MohamedMoustafa-embed/Alwah-project/مشروع الواح/Three-Band-Resistor-Color-Code.jpg

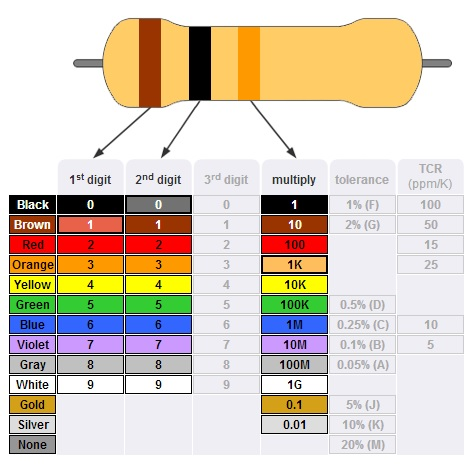
مشروع الواح/Three-Band-Resistor-Color-Code.jpg
