MohamedMoustafa-embed/Alwah-project/مشروع الواح/FRIIQKTJFIIWAOO.png

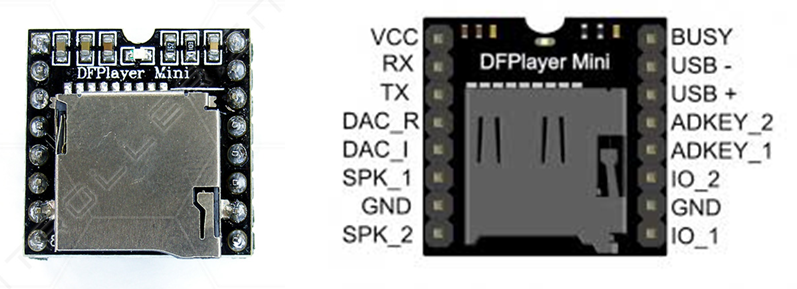
مشروع الواح/FRIIQKTJFIIWAOO.png
