MohamedMoustafa-embed/Alwah-project/مشروع الواح/PCB/Buttons_tray/push buttons.png

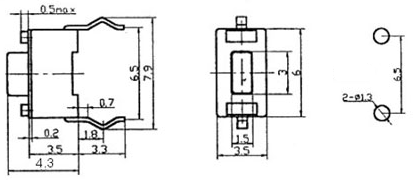
مشروع الواح/PCB/Buttons_tray/push buttons.png
