MohamedMoustafa-embed/Alwah-project/مشروع الواح/PCB/smd-resistor.png

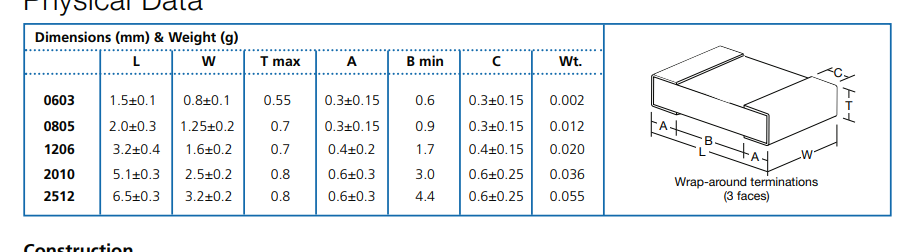
مشروع الواح/PCB/smd-resistor.png
