MohamedMoustafa-embed/Alwah-project/مشروع الواح/PCB/V2-1layer/tp4056.png

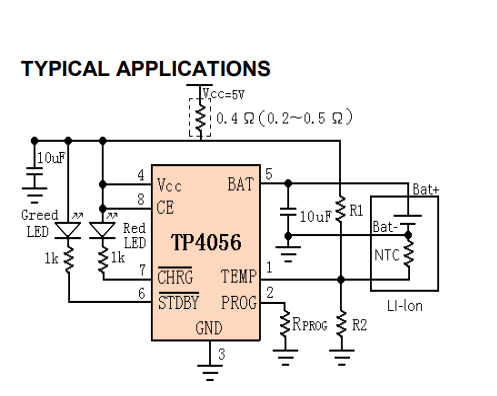
مشروع الواح/PCB/V2-1layer/tp4056.png
