MohamedMoustafa-embed/Alwah-project/مشروع الواح/untitled.png

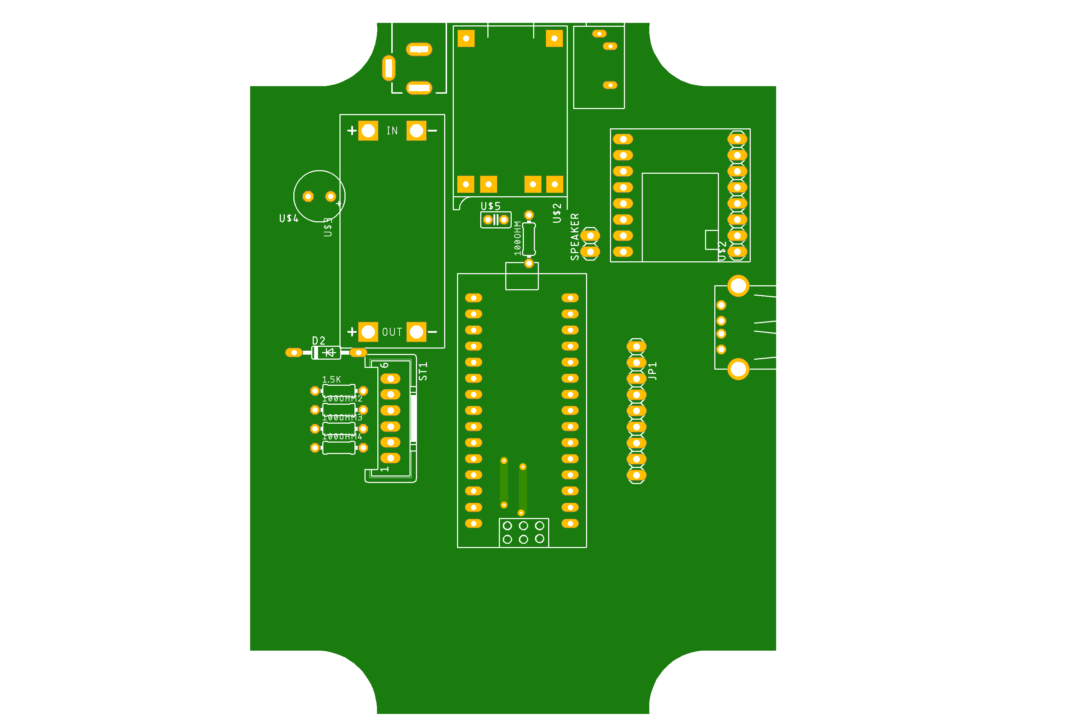
مشروع الواح/untitled.png
