MohamedMoustafa-embed/Alwah-project/Untitled spreadsheet.xlsx

Battery | 20 | tot | 10989.25249 |  | pricing list for Alwah Project |  |  |  |  | Estimating
battery holder | 10 |  |  |  | part1 | PCB |  |  |  | Board Alwah for one device | 20
battery charge module | 20 |  |  |  |  | Quantity | price |  |  | push-buttons for one board
Switches *20 | 10 |  |  |  |  | 75 | 3000 | 2200 | shipping and pproduct
Long switches *22 | 11 |  |  |  |  |  |  | 800 | customs
Arduino | 90
Mp3 | 100 |  |  |  | part2 | Components | From makers elecctronics
wires | 10 |  |  |  |  | Battery | 45
case | 50 |  |  |  |  | Charching module | 18
pcb fabrication | 30 |  |  |  |  | Step-up converter | 20
Sd card |  |  |  |  |  | At-mega8 | 30 | 28 at Ram electronic iin cairo
atmega | 35 |  |  |  |  | MP3 -Module | 60
push buttons *6 | 15 |  |  |  |  | Speaker | 8
additional as res, cap | 10 |  |  |  |  | socket | 8
step up module | 20 |  |  |  |  | LEDs | 1
printing | 15 |  |  |  |  | sd card | 26
 |  |  |  |  |  | additional compo | 20 | connectors,resistors,capacitor,switch,regulator 5v
 |  |  |  |  |  | caase | 40
 |  |  |  |  |  | push buttons
 |  |  |  |  |  |  | 276
 |  |  |  |  | part3 | Board Alwah
 |  |  |  |  |  | Push-buttons | 10
 |  |  |  |  |  | Wood | 7
 |  |  |  |  |  | cutting | 3
 |  |  |  |  |  | printing | 7
 |  |  |  |  |  | wax | 1
ADC calculator
 |  |  |  |  |  |  | 28
R1 | 152.8 | ohm |  | R1 | 10000 | ohm
R2(out) | 10 | ohm |  | R2(out) | 10 | ohm
vin | 5 | v |  | vin | 5 | v
voltage | 0.3071253071 | volt |  | voltage | 0.004995004995 | volt
ADC-readings-8bit(1023) | 62.8992629 |  |  | ADC-readings-8bit(1023) | 1.022977023
 |  | Difrrence | 61.87628588
ADC | 60 |  | 1~5 | "+1k"
R1 | 20 |  | 6~7 | "+1.2k"
R2(out) | 1.246105919 |  | 8~10 | "+2.2k"
ADC | 1
R2(out) | 10
R1 | 10220 |  | new R | 10067.2
