MohamedMoustafa-embed/Alwah-project/مشروع الواح/PCB/Buttons_tray/choosing-ayah-buttons.dxf

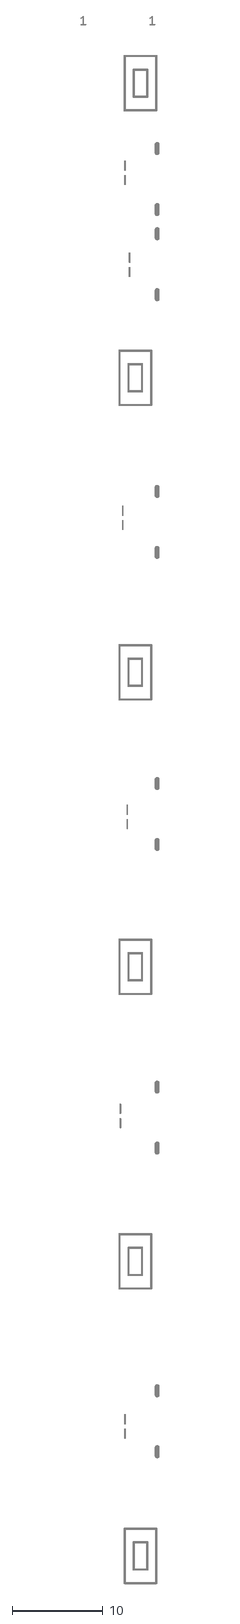
[picture p7: CAD file, 2022-02-24]
مشروع الواح/PCB/Buttons_tray/choosing-ayah-buttons.dxf
8.71 x 173.1
