MohamedMoustafa-embed/Alwah-project/مشروع الواح/PCB/settings-Buttons_tray/buttons.dxf

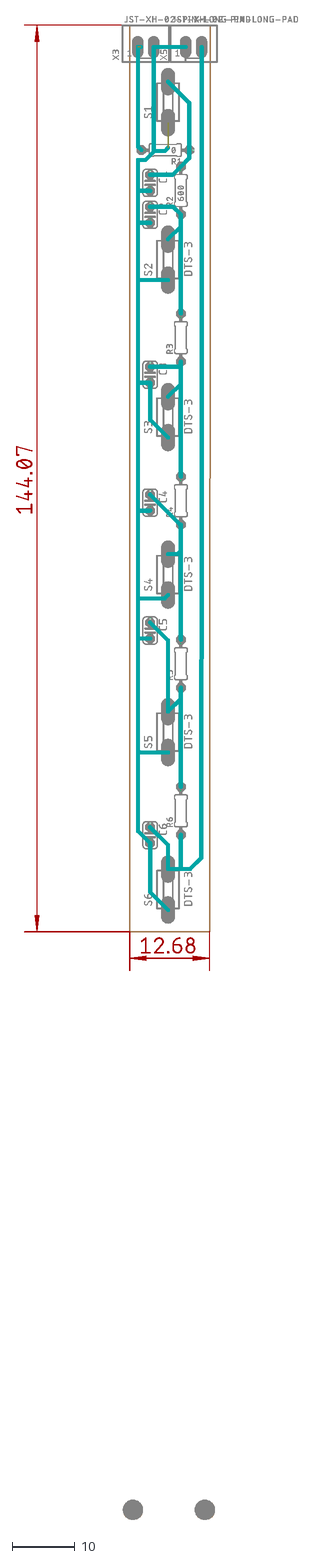
[picture p8: CAD file, 2022-02-24]
مشروع الواح/PCB/settings-Buttons_tray/buttons.dxf
44.7 x 238.9
