MohamedMoustafa-embed/Alwah-project/(list of files, cad)

Other CAD files:
مشروع الواح/Design/Alwah New DEVICE.dwg
مشروع الواح/PCB/settings-Buttons_tray/buttonsAutocad.dwg
مشروع الواح/PCB/Buttons_tray/buttonsAutocad.dxf
مشروع الواح/PCB/Buttons_tray/Alwah New DEVICE.dwg
