MohamedMoustafa-embed/Alwah-project/مشروع الواح/PCB/V1/1.pdf

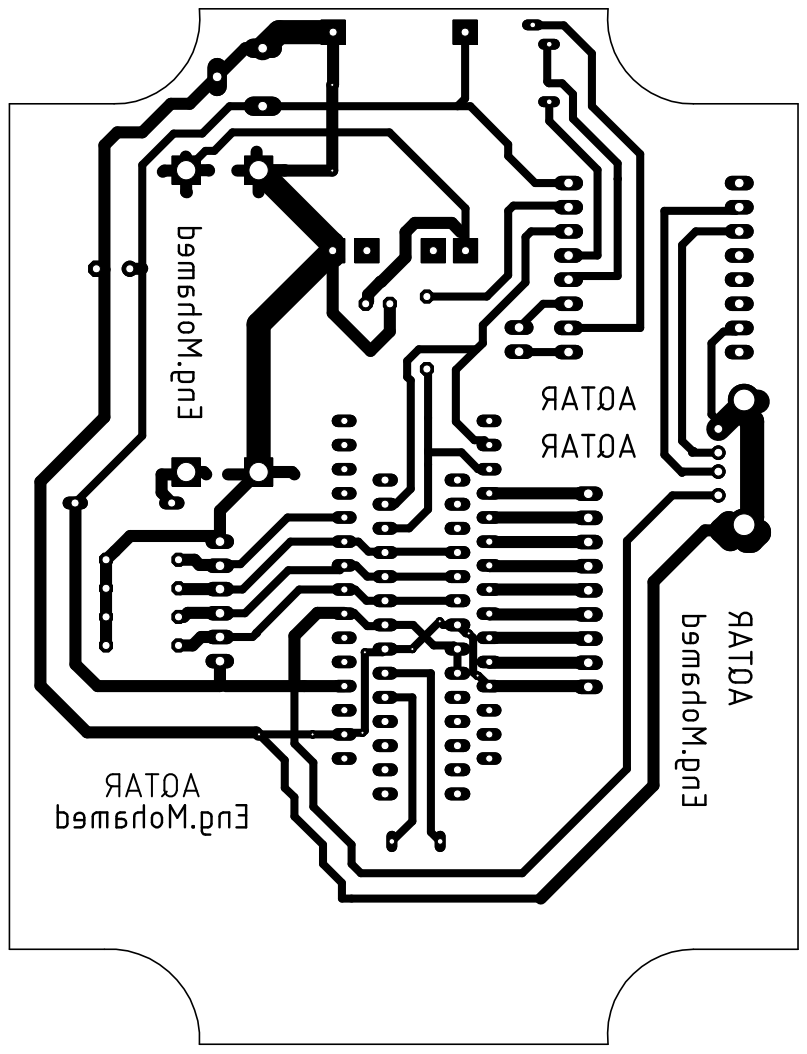
[picture p9: page 1]
