MohamedMoustafa-embed/Alwah-project/مشروع الواح/PCB/V1/2.pdf

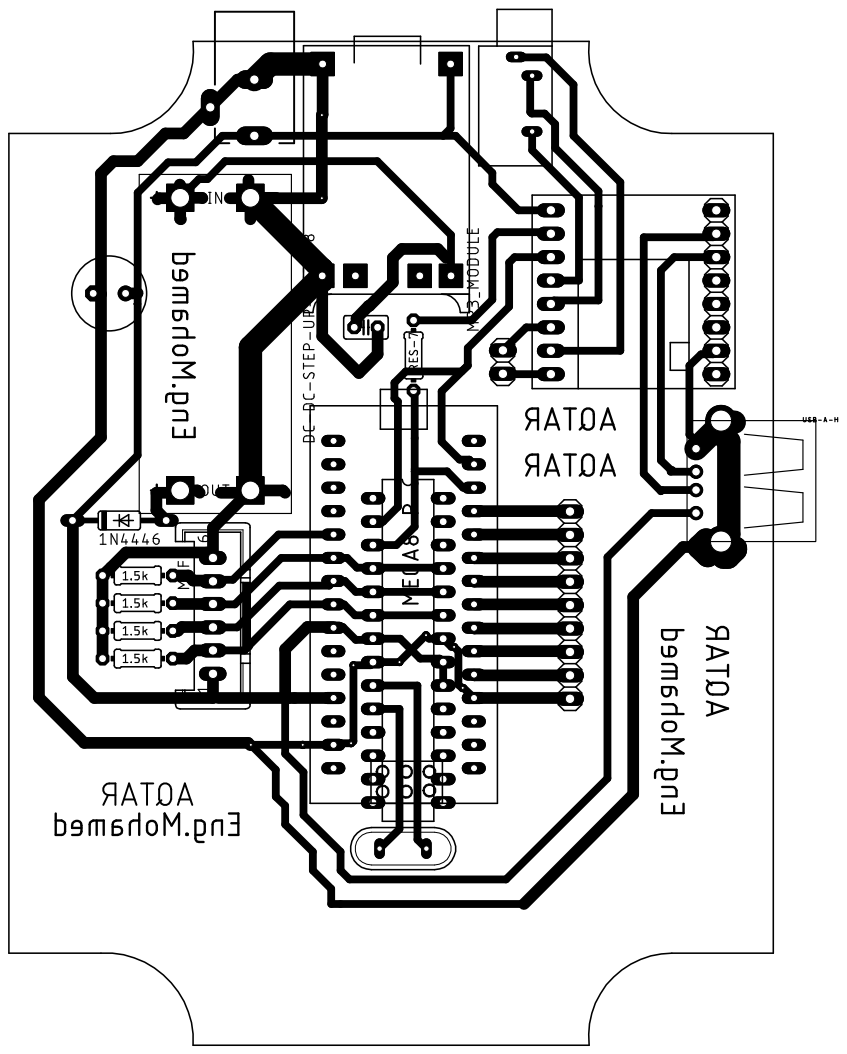
[picture p10: page 1]
