MohamedMoustafa-embed/Alwah-project/(list of files, drawings)

Other design files:
مشروع الواح/simulation/alwah.pdsprj
