MohamedMoustafa-embed/Alwah-project/مشروع الواح/PCB/V2-2layer/V2-2layer.brd

## EAGLE design مشروع الواح/PCB/V2-2layer/V2-2layer.brd (2022-02-24)

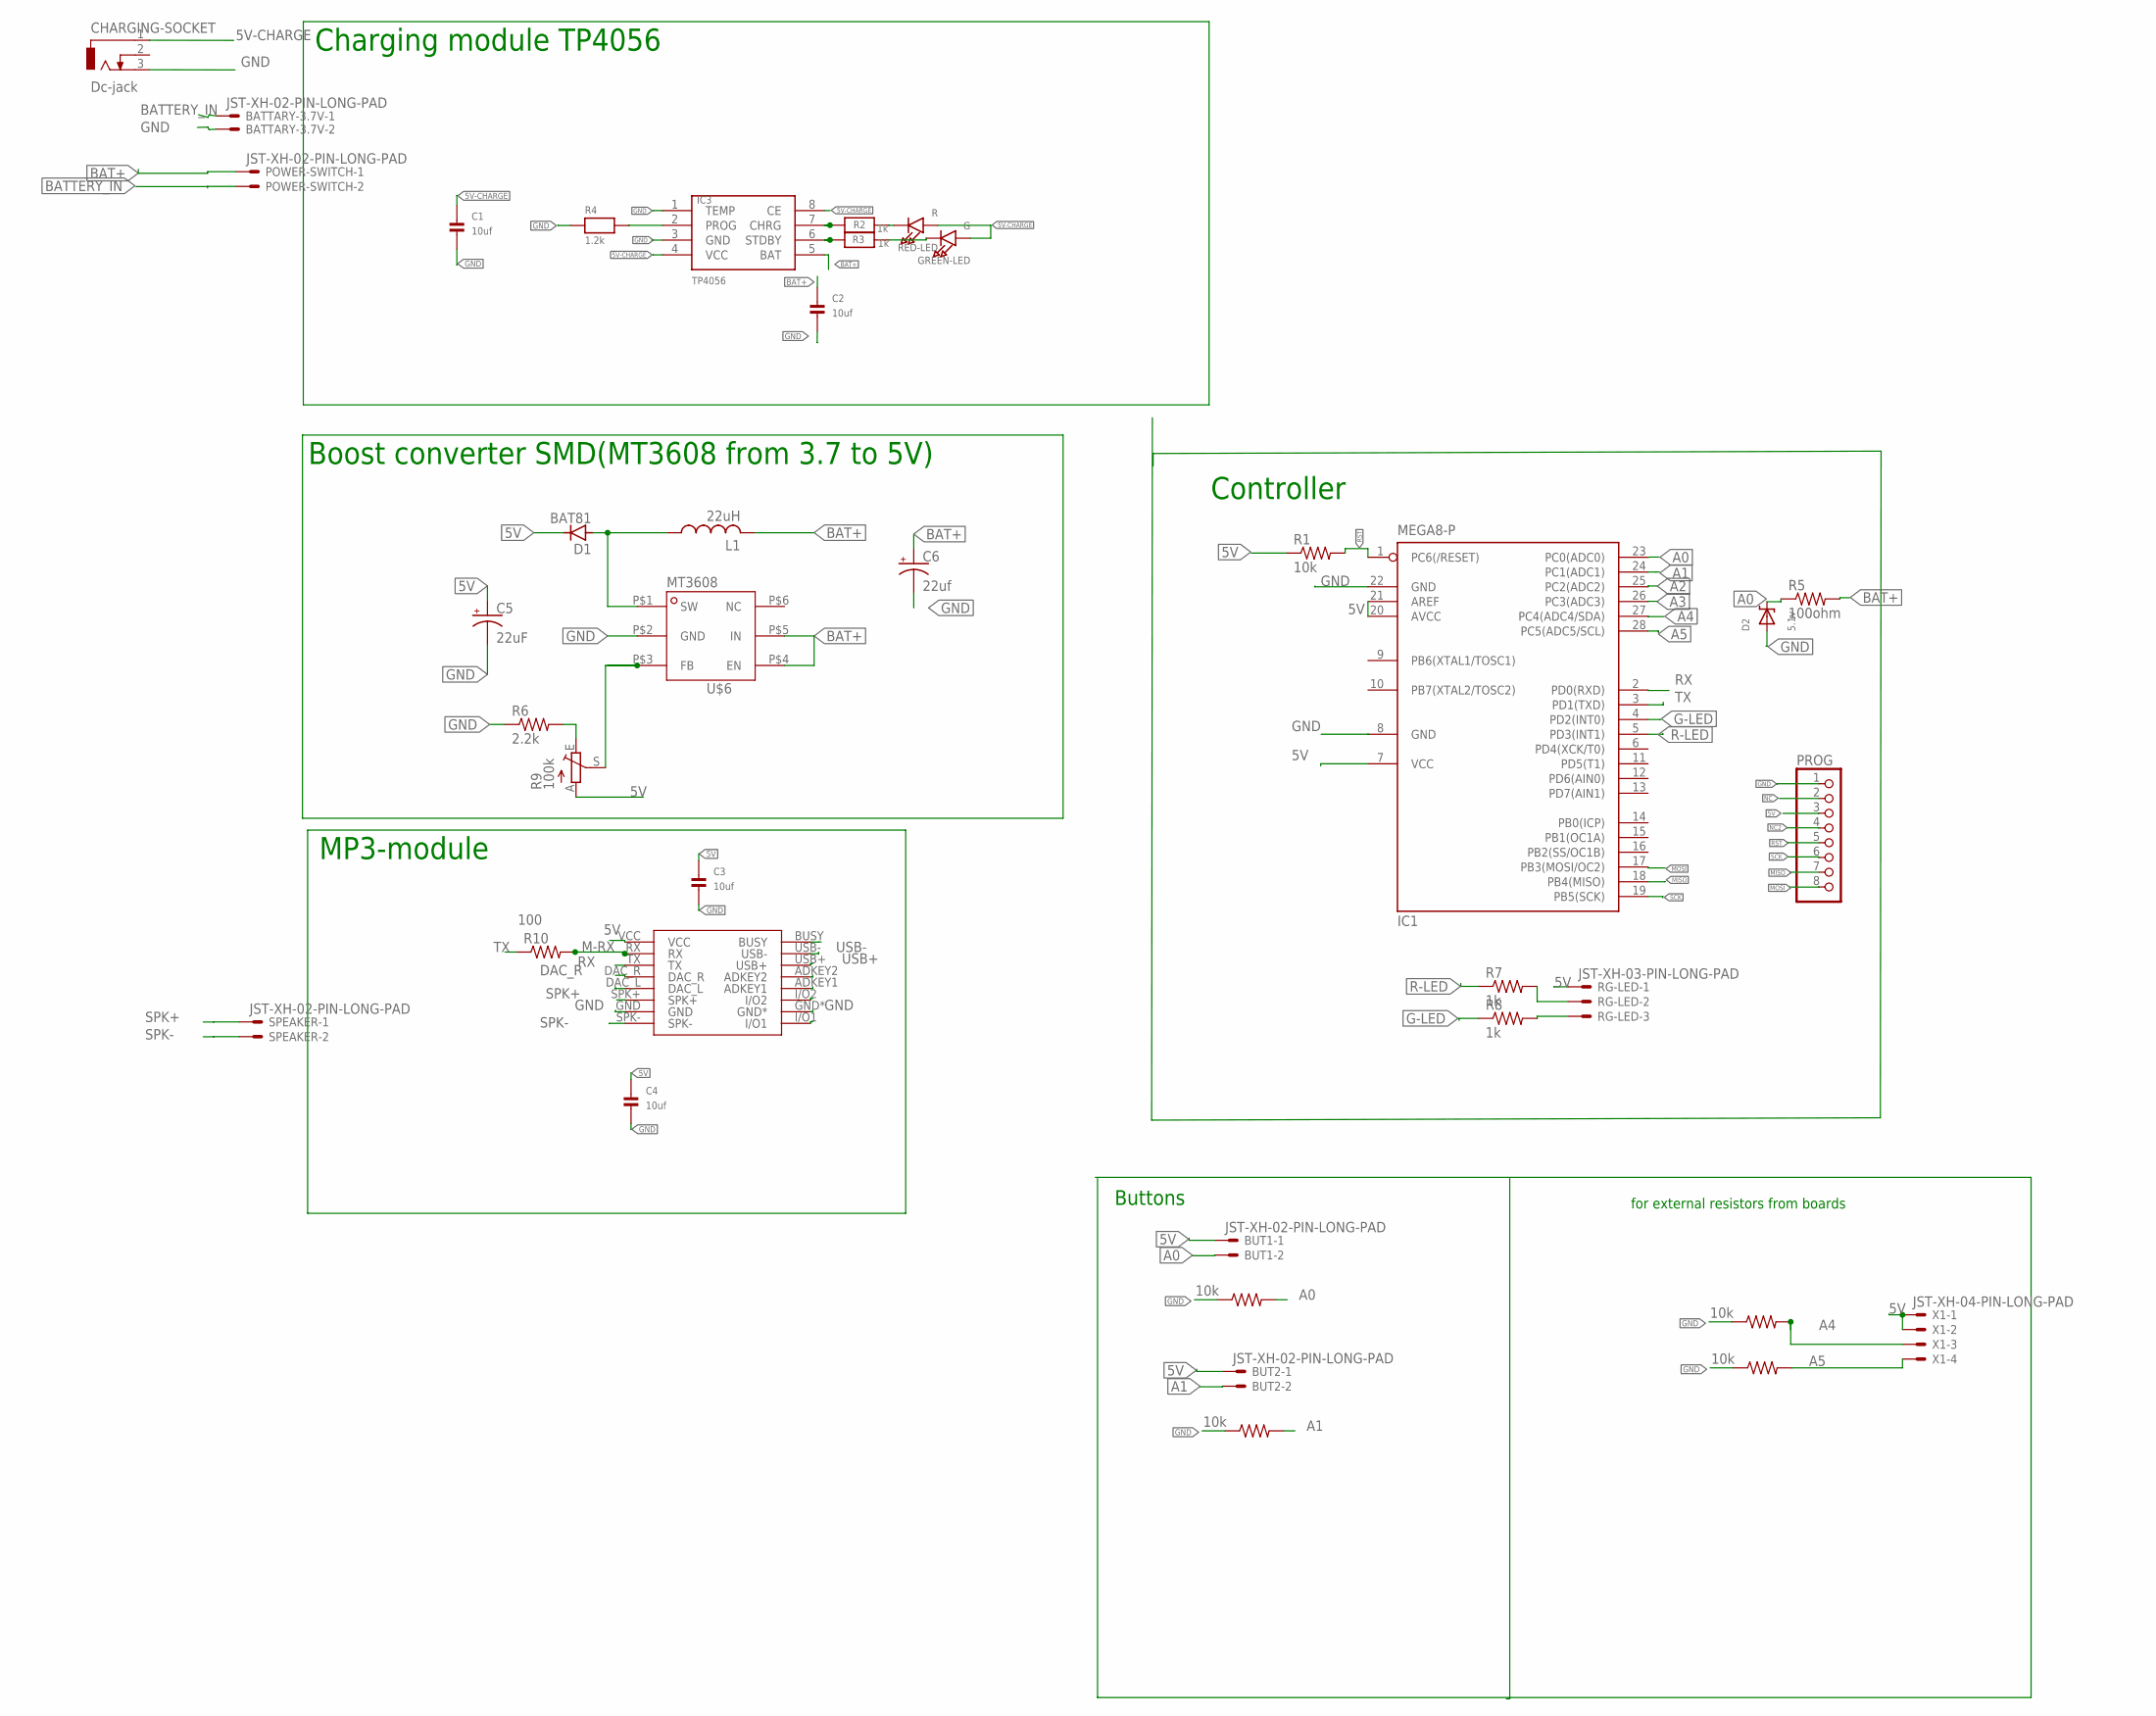
[picture p11: schematic V2-2layer.sch]

Parts:
BATTARY-3.7V: JST-XH-02-PIN-LONG-PAD; JST-XH-02-PACKAGE-LONG-PAD
BUT1, BUT2: JST-XH-02-PIN-LONG-PAD; JST-XH-02-PACKAGE-LONG-PAD
C1, C2, C3, C4: 10uf; 0805
C5: 22uF; E2,5-6E
C6: 22uf; E2,5-6E
CHARGING-SOCKET: Dc-jack; DCJ0303
D1: BAT81; DO34-7
D2: 5.1v; SMADIODE
GREEN-LED: G; CHIPLED_0805
IC1: MEGA8-P; DIL28-3
IC3: TP4056; SOP-8
KEYPADS, KEYPADS1, KEYPADS2, KEYPADS3: 10k; 0204/7
L1: 22uH; L1812
POWER-SWITCH: JST-XH-02-PIN-LONG-PAD; JST-XH-02-PACKAGE-LONG-PAD
PROG: PINHD-1X8; 1X08
R1: 10k; 0204/7
R2, R3: 1k; _0805
R4: 1.2k; _0805
R5: 100ohm; 0204/7
R6: 2.2k; M0805
R7, R8: 1k; 0204/7
R9: 100k; B25U
R10: 100; 0204/7
RED-LED: R; CHIPLED_0805
RG-LED: JST-XH-03-PIN-LONG-PAD; JST-XH-03-PACKAGE-LONG-PAD
SPEAKER: JST-XH-02-PIN-LONG-PAD; JST-XH-02-PACKAGE-LONG-PAD
U$2: MP3_MODULE
U$6: MT3608SOT23-6; SOT23-6
X1: JST-XH-04-PIN-LONG-PAD; JST-XH-04-PACKAGE-LONG-PAD

Connections:
5V: BUT1.1, BUT2.1, C3.1, C4.1, C5.+, D1.C, IC1.7 (VCC), IC1.20 (AVCC), IC1.21 (AREF), PROG.3, R1.1, R9.A, RG-LED.1, U$2.VCC, X1.1, X1.2
5V-CHARGE: C1.1, CHARGING-SOCKET.1, GREEN-LED.A, IC3.4 (VCC), IC3.8 (CE), RED-LED.A
A0: BUT1.2, D2.C, IC1.23 (PC0(ADC0)), KEYPADS.2, R5.1
A1: BUT2.2, IC1.24 (PC1(ADC1)), KEYPADS3.2
A2: IC1.25 (PC2(ADC2))
A3: IC1.26 (PC3(ADC3))
A4: IC1.27 (PC4(ADC4/SDA)), KEYPADS1.2, X1.3
A5: IC1.28 (PC5(ADC5/SCL)), KEYPADS2.2, X1.4
BAT+: C2.1, C6.+, IC3.5 (BAT), L1.2, POWER-SWITCH.1, R5.2, U$6.P$4 (EN), U$6.P$5 (IN)
BATTERY_IN: BATTARY-3.7V.1, POWER-SWITCH.2
DAC_L: U$2.DAC_L
DAC_R: U$2.DAC_R
G-LED: IC1.4 (PD2(INT0)), R8.1
GND: BATTARY-3.7V.2, C1.2, C2.2, C3.2, C4.2, C5.-, C6.-, CHARGING-SOCKET.3, D2.A, IC1.8 (GND), IC1.22 (GND), IC3.1 (TEMP), IC3.3 (GND), KEYPADS.1, KEYPADS1.1, KEYPADS2.1, KEYPADS3.1, PROG.1, R4.1, R6.1, U$2.GND, U$2.GND*, U$6.P$2 (GND)
M-RX: R10.2, U$2.RX
MISO: IC1.18 (PB4(MISO)), PROG.7
MOSI: IC1.17 (PB3(MOSI/OC2)), PROG.8
unnamed: IC3.2 (PROG), R4.2
unnamed: R7.2, RG-LED.2
unnamed: R8.2, RG-LED.3
unnamed: IC3.7 (CHRG), R2.1
unnamed: IC3.6 (STDBY), R3.1
unnamed: GREEN-LED.C, R3.2
unnamed: R6.2, R9.E
unnamed: R2.2, RED-LED.C
unnamed: R9.S, U$6.P$3 (FB)
unnamed: D1.A, L1.1, U$6.P$1 (SW)
NC: PROG.2
NC2: PROG.4
R-LED: IC1.5 (PD3(INT1)), R7.1
RST: IC1.1 (PC6(/RESET)), PROG.5, R1.2
RX: IC1.2 (PD0(RXD)), U$2.TX
SCK: IC1.19 (PB5(SCK)), PROG.6
SPK+: SPEAKER.1, U$2.SPK+
SPK-: SPEAKER.2, U$2.SPK-
TX: IC1.3 (PD1(TXD)), R10.1
USB+: U$2.USB+
USB-: U$2.USB-

Notes on the sheet:
Boost converter SMD(MT3608 from 3.7 to 5V)
MP3-module
Charging module TP4056
Controller
Buttons
for external resistors from boards

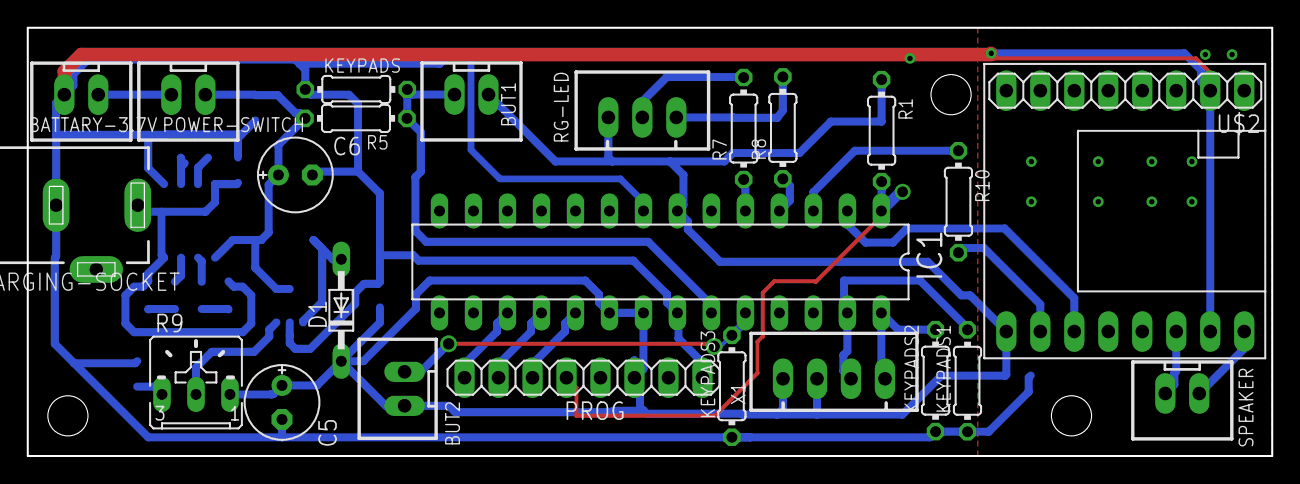
[picture p12: board V2-2layer.brd from above]

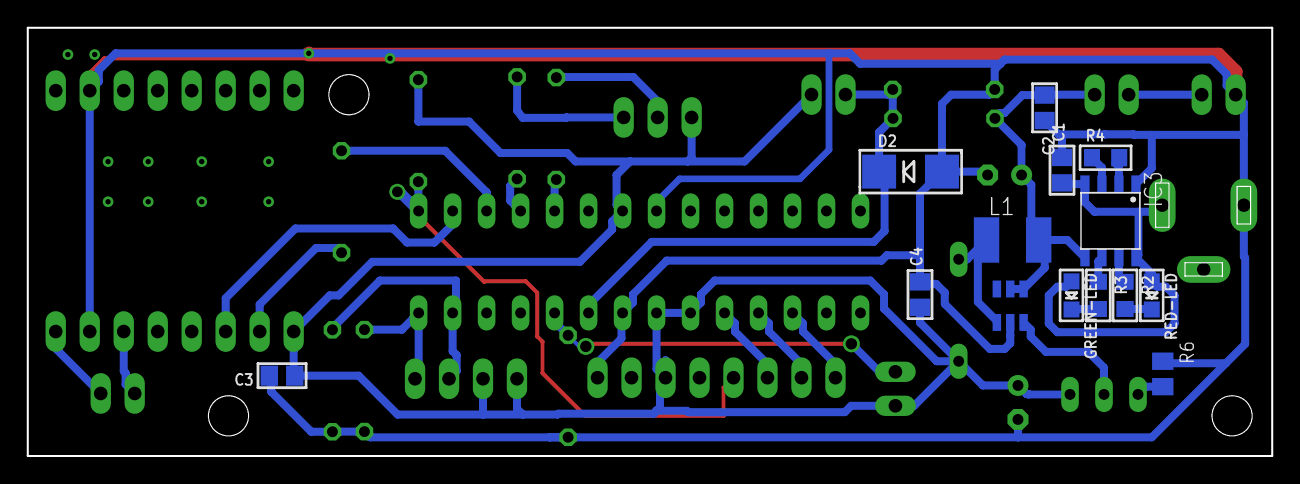
[picture p13: board V2-2layer.brd from below]

Board: 2 copper layers, 93.0 x 32.0 mm, 38 parts (14 on the bottom side), 30 nets.
