MohamedMoustafa-embed/Alwah-project/مشروع الواح/PCB/V1/untitled.brd

## EAGLE design مشروع الواح/PCB/V1/untitled.brd (2022-02-24)

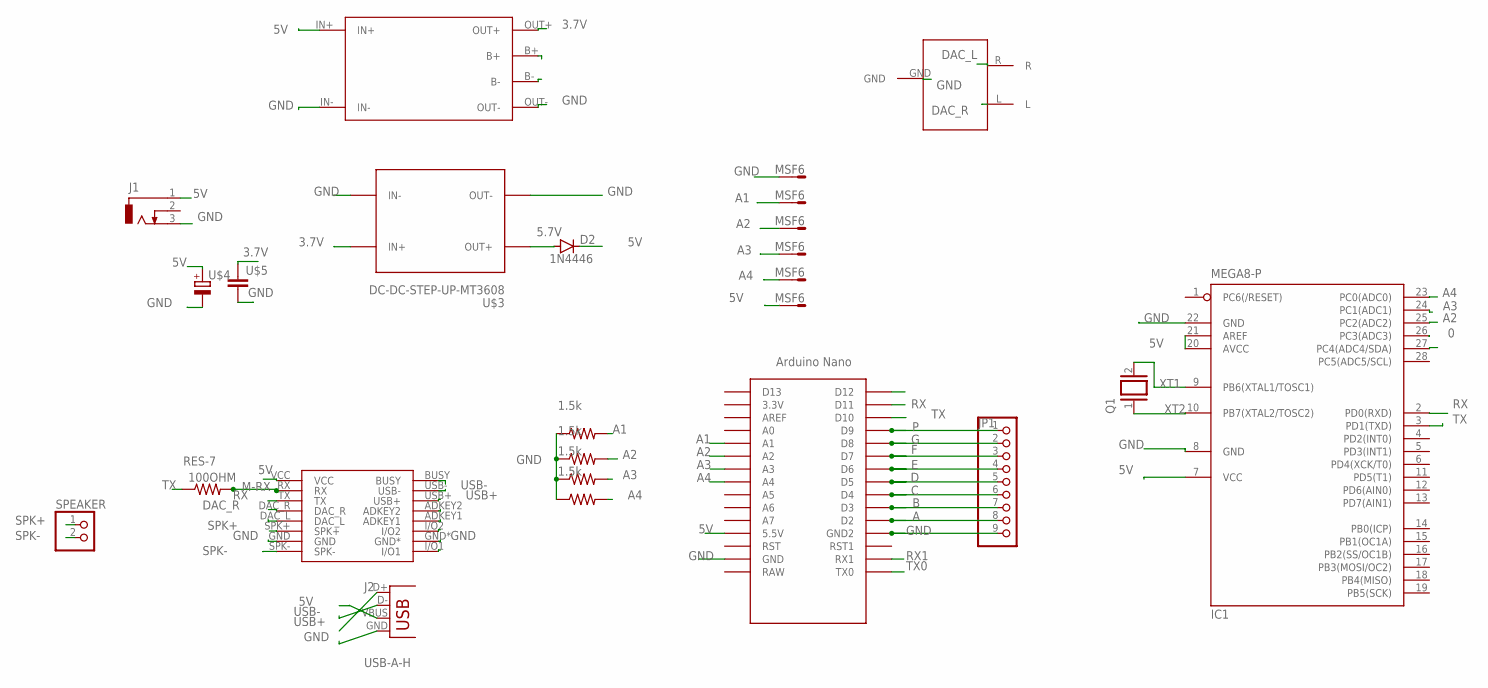
[picture p14: schematic untitled.sch]

Parts:
1.5K, 100OHM2, 100OHM3, 100OHM4: 1.5k; 0204/7
100OHM: RES-7; 0204/7
D2: 1N4446; DO35-10
IC1: MEGA8-P; DIL28-3
J1: CON_JACK; DCJ0303
J2: USB-A-H
JP1: PINHD-1X9; 1X09
Q1: XTAL/S; QS
SPEAKER: PINHD-1X2; 1X02
ST1: MSF6
U$1: ARDUINO_NANO; NANO
U$2: MP3_MODULE
U$3: DC-DC-STEP-UP-MT3608
U$4: CAP_POL; E3,5-8
U$5: CAPACITOR; C025-025X050
U$6: LITHIUM_CHARGER_2A; LITHIUM-CHARGER-1A
U$7: EAR-PHONE-SOCKET

Connections:
0: IC1.26 (PC3(ADC3))
3.7V: U$3.IN+, U$5.1, U$6.OUT+
5.7V: D2.A, U$3.OUT+
5V: D2.C, IC1.7 (VCC), IC1.20 (AVCC), IC1.21 (AREF), J1.1, J2.VBUS, ST1.1, U$1.5V (5.5V), U$2.VCC, U$4.+, U$6.IN+
A: JP1.8, U$1.D2
A1: 1.5K.2, ST1.5, U$1.A1
A2: 100OHM2.2, IC1.25 (PC2(ADC2)), ST1.4, U$1.A2
A3: 100OHM3.2, IC1.24 (PC1(ADC1)), ST1.3, U$1.A3
A4: 100OHM4.2, IC1.23 (PC0(ADC0)), ST1.2, U$1.A4
B: JP1.7, U$1.D3
C: JP1.6, U$1.D4
D: JP1.5, U$1.D5
DAC_L: U$2.DAC_L, U$7.R
DAC_R: U$2.DAC_R, U$7.L
E: JP1.4, U$1.D6
F: JP1.3, U$1.D7
G: JP1.2, U$1.D8
GND: 1.5K.1, 100OHM2.1, 100OHM3.1, 100OHM4.1, IC1.8 (GND), IC1.22 (GND), J1.3, J2.GND, JP1.9, ST1.6, U$1.GND, U$1.GND1 (GND2), U$2.GND, U$2.GND*, U$3.IN-, U$3.OUT-, U$4.-, U$5.2, U$6.IN-, U$6.OUT-, U$7.GND
M-RX: 100OHM.2, U$2.RX
P: JP1.1, U$1.D9
RX: IC1.2 (PD0(RXD)), U$1.D11, U$2.TX
RX1: U$1.RX1
SPK+: SPEAKER.1, U$2.SPK+
SPK-: SPEAKER.2, U$2.SPK-
TX: 100OHM.1, IC1.3 (PD1(TXD)), U$1.D10
TX0: U$1.TX0
USB+: J2.D+, U$2.USB+
USB-: J2.D-, U$2.USB-
XT1: IC1.9 (PB6(XTAL1/TOSC1)), Q1.2
XT2: IC1.10 (PB7(XTAL2/TOSC2)), Q1.1

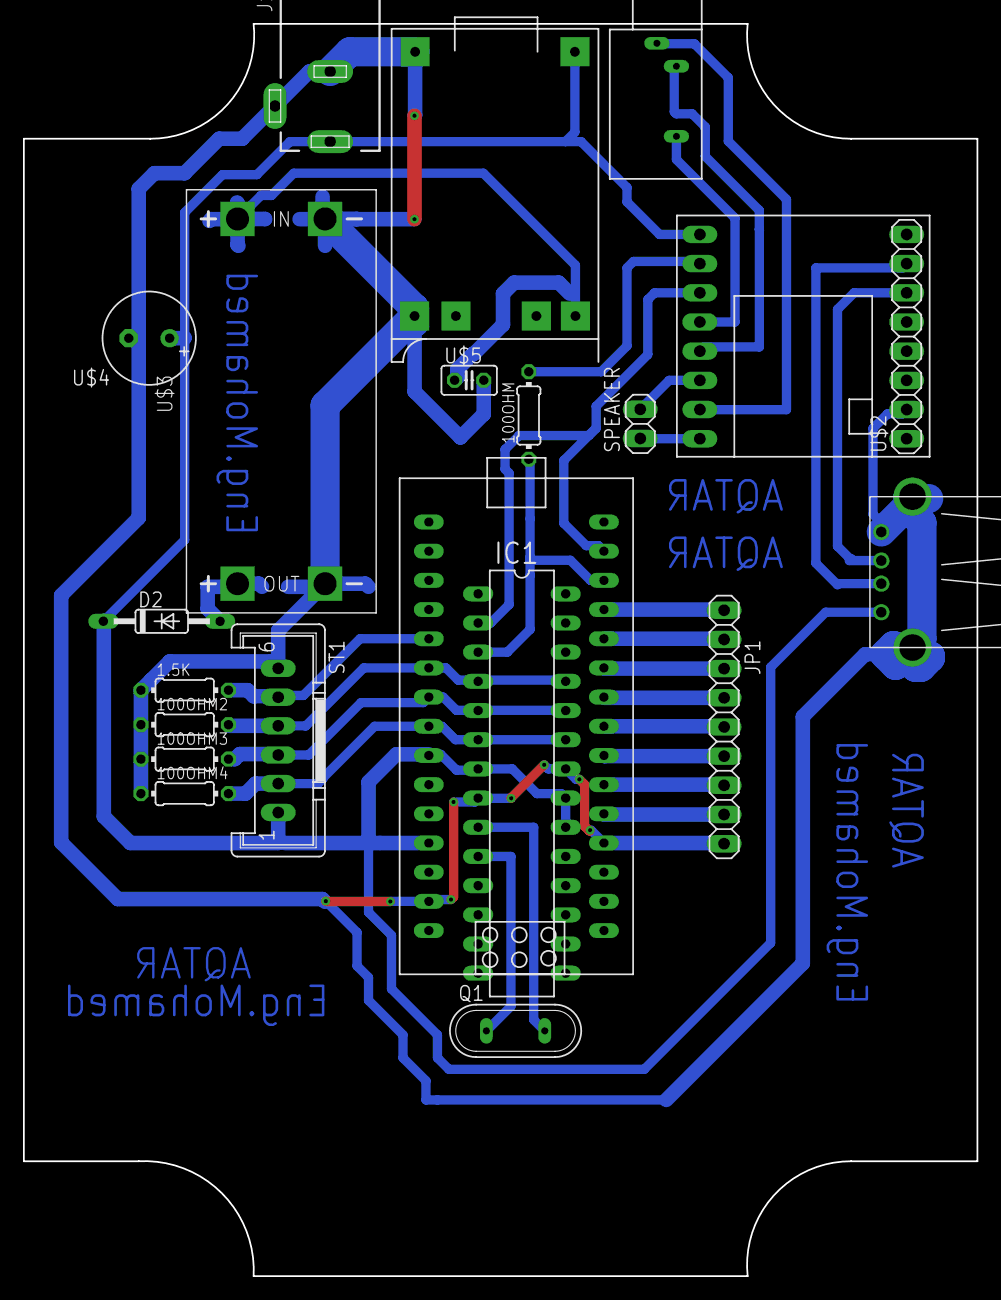
[picture p15: board untitled.brd from above]

Board: 2 copper layers, 83.0 x 109.0 mm, 20 parts (0 on the bottom side), 27 nets.
