MohamedMoustafa-embed/Alwah-project/مشروع الواح/PCB/settings-Buttons_tray/buttons.brd

## EAGLE design مشروع الواح/PCB/settings-Buttons_tray/buttons.brd (2022-02-24)

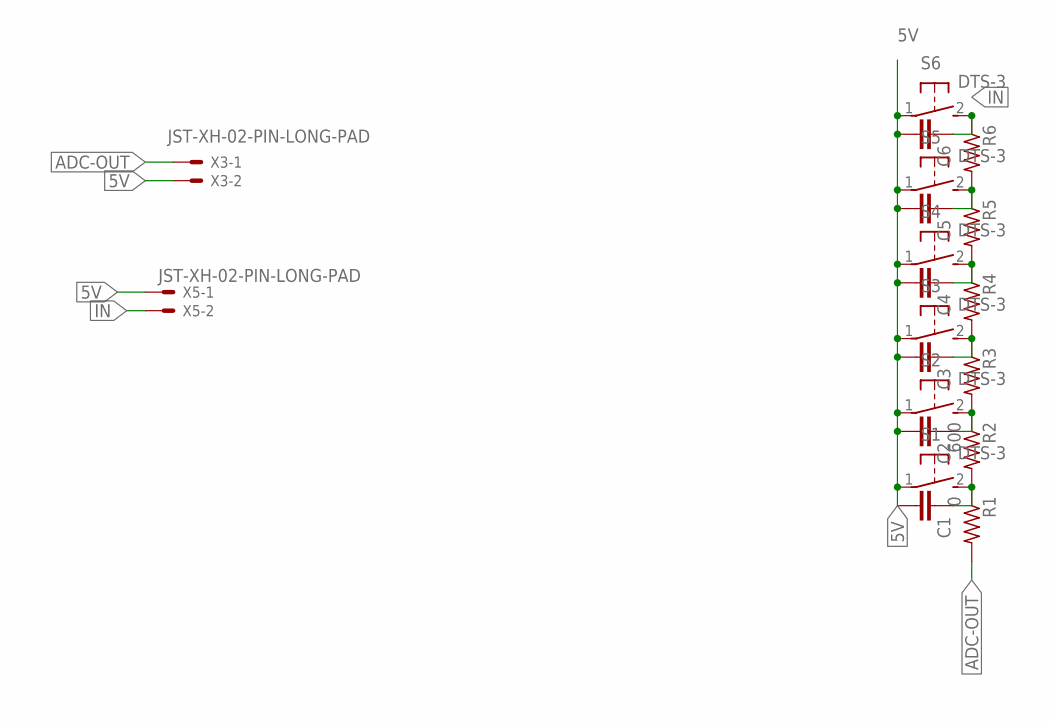
[picture p16: schematic buttons.sch]

Parts:
C1, C2, C3, C4, C5, C6: C-EU025-024X044; C025-024X044
R1: 0; 0204/7
R2: 600; 0204/7
R3, R4, R5, R6: R-US_0204/7; 0204/7
S1, S2, S3, S4, S5, S6: DTS-3
X3, X5: JST-XH-02-PIN-LONG-PAD; JST-XH-02-PACKAGE-LONG-PAD

Connections:
5V: C1.2, C2.2, C3.2, C4.2, C5.2, C6.2, S1.1, S2.1, S3.1, S4.1, S5.1, S6.1, X3.2, X5.1
ADC-OUT: R1.2, X3.1
IN: C6.1, R6.1, S6.2, X5.2
unnamed: C1.1, R1.1, R2.2, S1.2
unnamed: C2.1, R2.1, R3.2, S2.2
unnamed: C3.1, R3.1, R4.2, S3.2
unnamed: C4.1, R4.1, R5.2, S4.2
unnamed: C5.1, R5.1, R6.2, S5.2

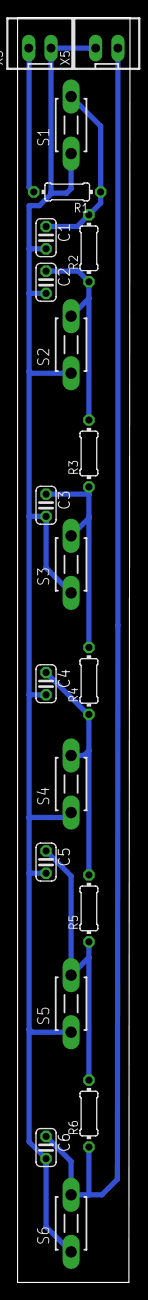
[picture p17: board buttons.brd from above]

Board: 2 copper layers, 12.8 x 144.1 mm, 20 parts (0 on the bottom side), 8 nets.
