MohamedMoustafa-embed/Alwah-project/(commit log)

2022-02-24 eddit design
    [Alwah New DEVICE.dwg, Untitled spreadsheet.xlsx, V2-1layer.brd, V2-1layer.sch, V2-2layer.brd, V2-2layer.sch, alwah.pdsprj, buttons.brd]
2022-02-24 edit pcb design
    [buttons.brd, buttons.sch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]
